joelpbr/TaikoProMicro/images/companion_zh.png

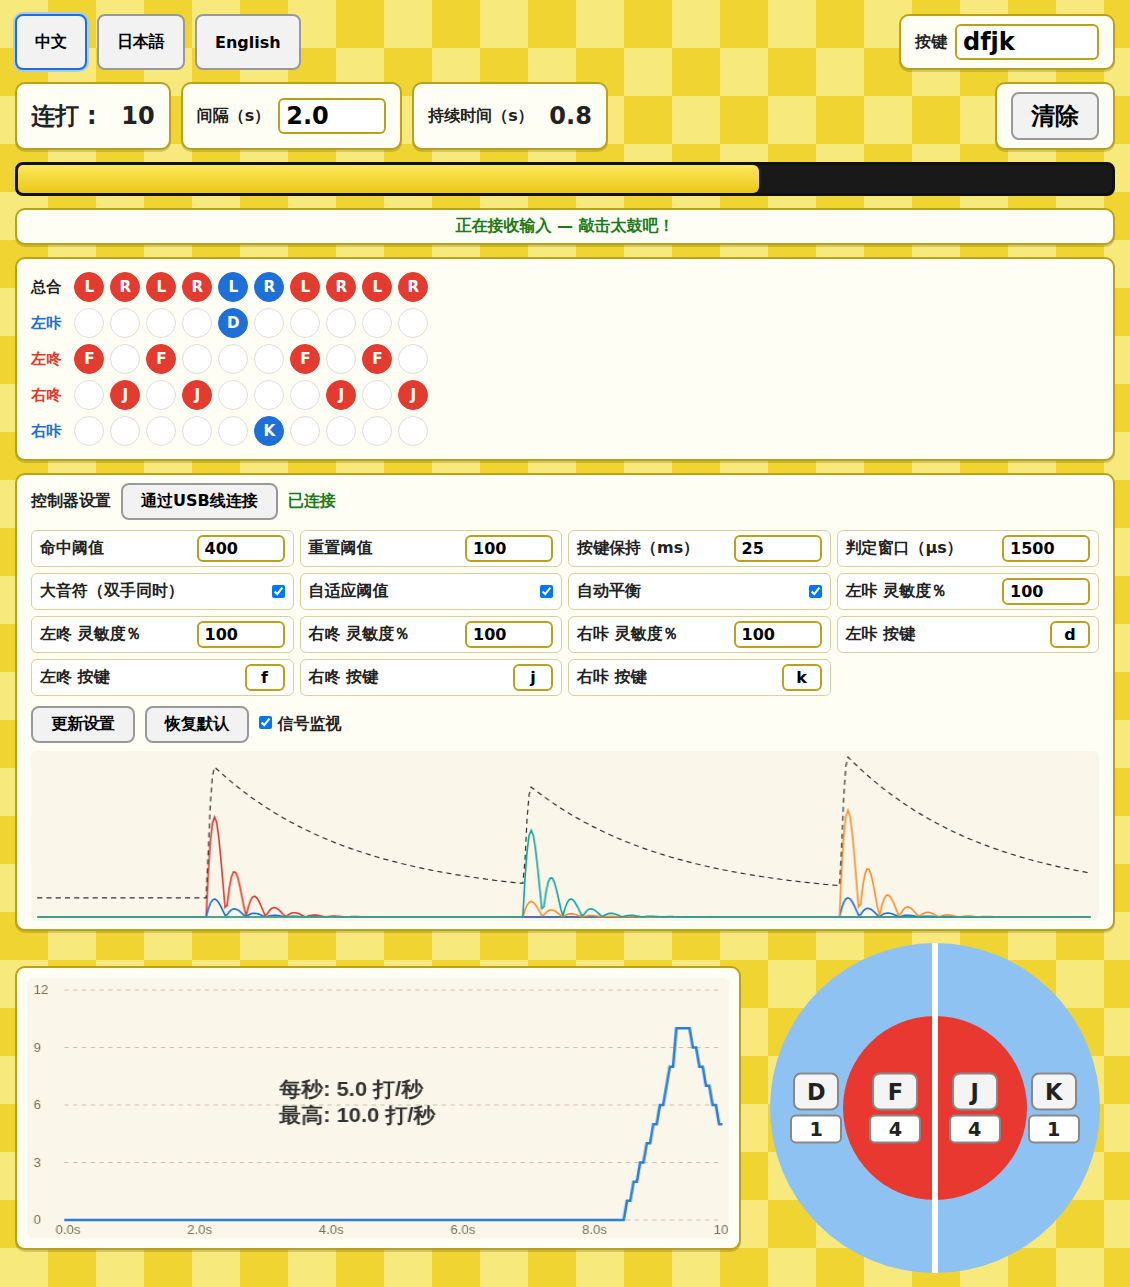
images/companion_zh.png
