joelpbr/TaikoProMicro/(commit log)

2024-10-25 Major changes
    - Removed non Pro Micro related stuff.
    - Code changed:
    > Removed the possibility of accidentally pressing same side don and ka.
    [BOM_PCB_Taiko Controller_2_2024-01-26.csv]
2024-10-25 Removed LED functionality
    - Removed LED functionality
2026-07-18 Arcade-grade hit detection, auto adjust, and companion app with live settings
    Firmware:
    - Rewrite hit detection: correct sliding-window energy, scan window that
    picks the loudest sensor (rejects crosstalk), 25 ms non-blocking key
    hold, two-hand big-note support, percent-based per-zone sensitivity.
    - Fix bugs: broken sensitivity math (exponential growth/decay of the
    power accumulator), wrong sample dropped from the sliding window,
    signed-char overflow in special keycodes, missed hits from zero-length
    key taps.
    - Auto adjust: noise-floor calibration at plug-in, adaptive hit
    threshold that rides each hit's live signal and decays back, and
    automatic gain balancing across the four z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
